hafuli123/AcGun-Gun-File/手册/0.91OLED/03-原理图/原理图.png

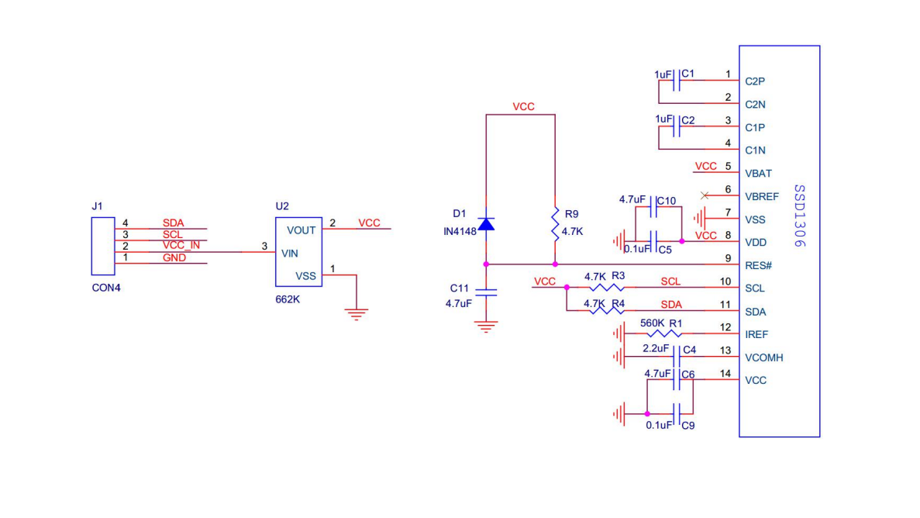
手册/0.91OLED/03-原理图/原理图.png
