hafuli123/AcGun-Gun-File/素材/PCtoLCD/取字设置.png

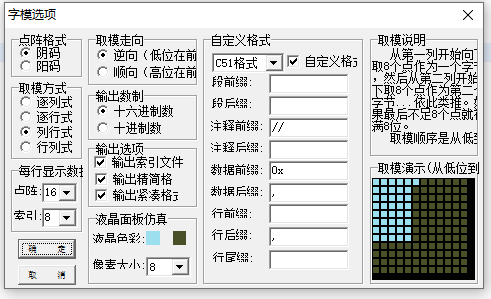
素材/PCtoLCD/取字设置.png
