hafuli123/AcGun-Gun-File/素材/PCtoLCD/字库工具/BAT(1).bmp

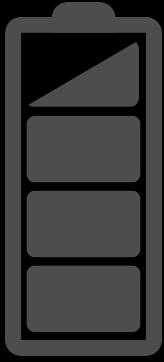
素材/PCtoLCD/字库工具/BAT(1).bmp
