hafuli123/AcGun-Gun-File/素材/PCtoLCD/字库工具/d4q25JmE3j.bmp

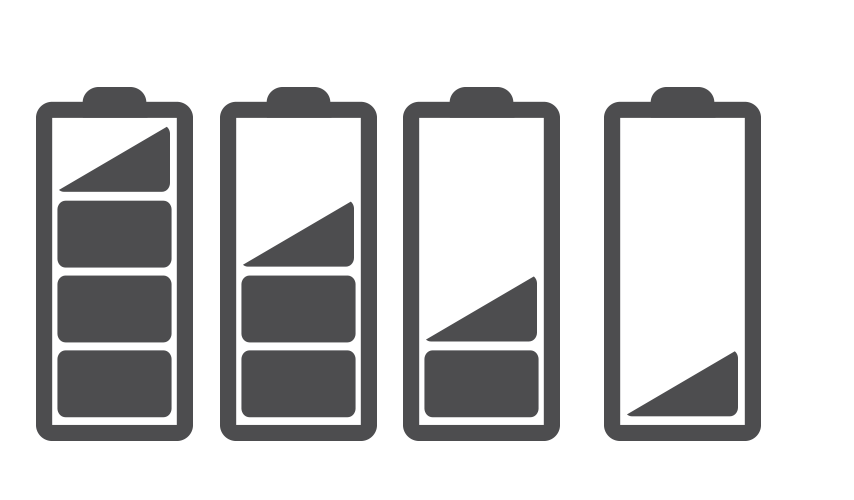
素材/PCtoLCD/字库工具/d4q25JmE3j.bmp
