hafuli123/AcGun-Gun-File/素材/PCtoLCD/字库工具/exLqBQ9P3N.bmp

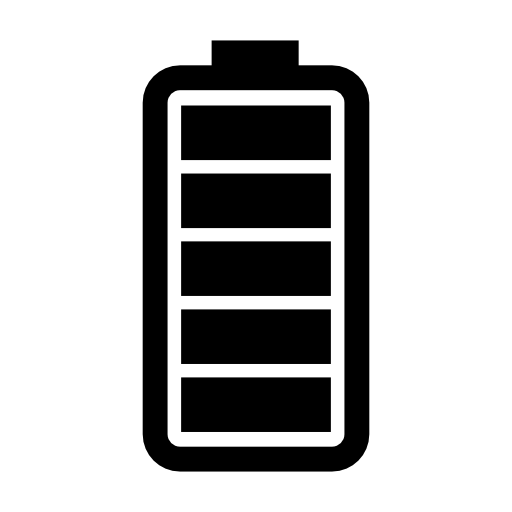
素材/PCtoLCD/字库工具/exLqBQ9P3N.bmp
