hafuli123/AcGun-Gun-File/硬件/H7相机板BOM.xlsx

No. | Quantity | Device | Designator | Footprint | Value
1 | 19 | CC0603KRX7R9BB104 | C1,C9,C12,C13,C16,C19,C20,C23,C26,C30,C32,C33,C34,C35,C36,C37,C38,C39，C40 | C0603 | 0.1uF
2 | 6 | CC0603KRX7R9BB105 | C2,C8,C14,C15,C29,C31 | C0603 | 1uF
3 | 2 | 0603X475M160NT | C3,C4 | C0603 | 4.7uF
4 | 3 | 0603CG220F500NT | C6,C27,C28 | C0603 | 22pF
5 | 8 | 0603X106K160NT | C5,C7，C10,C11,C17,C18,C21,C22 | C0603 | 10uF
6 | 2 | 0603CG150J500NT | C24,C25 | C0603 | 15pF
7 | 1 | HX25003-5A | CN1 | CONN-TH_5P-P2.50_HX25003-5A | 灯板连接口 2.54 5p直插 | 不贴
8 | 1 | HDGC2501WR-2P | CN2 | CONN-TH_2P-P2.50_HDGC2501WR-2P
9 | 1 | SS34_C8678 | D1 | DO-214AC_L4.3-W2.7-LS5.3-RD
10 | 2 | SS14A | D2,D3 | SMA_L4.3-W2.6-LS5.2-RD
11 | 4 | 3.3uh电感 | L1,L3,L4,L5 | 0420 | 3.3uH
12 | 1 | 2.2uh3a电感 | L2 | IND-SMD_L4.0-W4.0_0.47UH04209.5A | 2.2uH
13 | 1 | TLMG1100-GS08 | LED1 | 绿灯
14 | 1 | TLMG1100-GS08 | LED2 | 黄灯
15 | 1 | TLMS1000-GS08 | LED3 | 红灯
16 | 1 | AO3401_C181091 | Q1 | SOT-23-3_L2.9-W1.3-P1.90-LS2.4-BR
17 | 2 | AO3400 | Q2,Q3 | SOT-23_L2.9-W1.3-P1.90-LS2.4-BR
18 | 4 | 0603WAF1001T5E | R1,R19,R20,R21 | R0603 | 1kΩ
19 | 2 | 0603WAF2002T5E | R2,R17 | R0603 | 20kΩ
20 | 5 | 0603WAF1002T5E | R3,R4,R11,R14,R15 | R0603 | 10kΩ
21 | 2 | 0603WAF3002T5E | R5,R18 | R0603 | 30kΩ
22 | 1 | 0603WAF3001T5E | R6 | R0603 | 3kΩ
23 | 2 | 0603WAF4701T5E | R7,R8 | R0603 | 4.7kΩ
24 | 4 | 0603WAF1003T5E | R9,R12,R13,R25 | R0603 | 100kΩ
25 | 1 | RC0603FR-07453KL | R10 | R0603 | 453kΩ
26 | 1 | 0603WAF470JT5E | R16 | R0603 | 47Ω
27 | 1 | 0603WAF3003T5E | R22 | R0603 | 300kΩ
28 | 1 | 按键开关 | SW1 | 按钮开关
29 | 1 | 1TS001G-2700-1500-CT | SW3 | SW-SMD_4P-L5.1-W5.1-P3.70-LS6.5-TL-2
30 | 1 | 24M有源晶振 | U1 | 5032-4P |  | 不贴
31 | 1 | PW4056 | U2 | PW4056
32 | 1 | 相机排座 | U3 | OV2640
33 | 1 | HDGC1501WV-6P | U4 | CONN-TH_6P-P1.50_HDGC_HDGC1501WV-6P
34 | 1 | PW2051 | U5 | PW2051
35 | 2 | XC6206P282MR | U6,U10 | SOT-23-3_L2.9-W1.6-P1.90-LS2.9-BL
 | 1 | XC6206P132MR | U8 | SOT-23-3_L2.9-W1.6-P1.90-LS2.9-BL
36 | 1 | GC2400-TC010R | U7 | GC2400-TC010R
37 | 1 | W25Q64JVSSIQ_C83140 | U9 | SOP-8_L5.3-W5.3-P1.27-LS8.0-BL
38 | 1 | AS01-ML01IPX | U11 | WIRELM-SMD_8P-L19.0-W12.0-P1.27 |  | 不贴
39 | 1 | STM32H7B0VBT6 | U12 | LQFP-100_L14.0-W14.0-P0.50-LS16.0-BL
40 | 1 | XY-MBA32A | U13 | XY-MBA32A
41 | 1 | typec | USB1 | typec
42 | 1 | 32.768KHz晶振 | Y1 | 3215
43 | 1 | 25MHz无源晶振 | Y2 | XTAL3225
