hafuli123/AcGun-Gun-File/传感器两小板/pcb/压力板BOM.xlsx

No. | Quantity | Device | Designator | Footprint | Value
1 | 1 | 10cm 3P 线 | CN1 | 3POINT
2 | 1 | CR0603JA0103G | R1 | R0603 | 10kΩ
3 | 1 | FSS1500 | U1 | FSS1500NST
4 | 1 | INA333AIDGKR | U2 | MSOP-8_L3.0-W3.0-P0.65-LS5.0-BL
