hafuli123/AcGun-Gun-File/传感器两小板/pcb/磁感应板BOM.xlsx

No. | Quantity | Device | Designator | Footprint | Value
1 | 1 | 15cm 3P线 | CN1 | 3POINT
2 | 1 | TMR1302S | U1 | SOT-23-3_L2.9-W1.3-P1.90-LS2.4
