hafuli123/AcGun-Gun-File/硬件/激光主板BOM.xlsx

No. | Quantity | Device | Designator | Footprint | Value
1 | 1 | 0603F105M250NT | C1 | C0603 | 1uF
2 | 2 | 0603X475M160NT | C2,C4 | C0603 | 4.7uF
3 | 9 | 0603B104K101CT | C3,C6,C7,C8,C9,C10,C11,C14,C20 | C0603 | 0.1uF
4 | 3 | 0603X106M100CT | C5,C18,C22 | C0603 | 10uF
5 | 1 | 0603B225K160CT | C13 | C0603 | 2.2uF
6 | 2 | 0603CG150J500NT | C15,C16 | C0603 | 15pF
7 | 3 | 0603CG220F500NT | C17,C19,C21 | C0603 | 22pF
8 | 1 | HDGC2501WR-2P | CN1 | CONN-TH_2P-P2.50_HDGC2501WR-2P
9 | 1 | 喇叭 | CN2 | 喇叭接线点
10 | 3 | HDGC2001WR-2P | CN3,CN7,CN9 | CONN-TH_2P-P2.00_HDGC2001WR-2P
11 | 2 | HDGC1501WR-3P | CN4,CN5 | CONN-TH_3P-P1.50_HDGC1501WR-3P
12 | 1 | 1125-1104G0R138C002 | CN6 | HDR-TH_4P-P2.54-H-M-W9.4
13 | 1 | SS34_C8678 | D1 | DO-214AC_L4.3-W2.7-LS5.3-RD
14 | 2 | SS14A | D2,D3 | SMA_L4.3-W2.6-LS5.2-RD
15 | 1 | 2.2uh3a电感 | L1 | IND-SMD_L4.0-W4.0_0.47UH04209.5A | 2.2uH
16 | 1 | AO3401_C181091 | Q1 | SOT-23-3_L2.9-W1.3-P1.90-LS2.4-BR
17 | 2 | AO3400 | Q2,Q4 | SOT-23_L2.9-W1.3-P1.90-LS2.4-BR
18 | 4 | S8050 | Q5,Q6,Q7 | SOT-23_L2.9-W1.3-P1.90-LS2.4-BR
19 | 1 | FMMT493 | Q3 | SOT-23-3
20 | 2 | RC0603DR-0720KL | R1,R3 | R0603 | 20kΩ
21 | 5 | TR0603B1K00P0525Z | R2,R10,R15,R19,R24 | R0603 | 1kΩ
22 | 10 | SY0603JN10KP | R4,R7,R11,R12,R13,R17,R18,R20,R22,R25 | R0603 | 10kΩ
23 | 1 | 0603WAJ0302T5E | R5 | R0603 | 3kΩ
24 | 2 | AC0603FR-0730KL | R6,R8 | R0603 | 30kΩ
25 | 4 | MCT06030C1003FP500 | R9,R16,R26,R27 | R0603 | 100kΩ
26 | 1 | RC0603FR-07300KL | R14 | R0603 | 300kΩ
27 | 1 | RMC 0603 4K7 F N | R21 | R0603 | 4.7kΩ
28 | 1 | 0603WAF4533T5E | R23 | R0603 | 453kΩ
29 | 2 | 按键开关 | SW1,SW2 | 按钮开关
30 | 1 | 1TS001G-2700-1500-CT | SW3 | SW-SMD_4P-L5.1-W5.1-P3.70-LS6.5-TL-2
31 | 1 | PW4056 | U1 | PW4056
32 | 1 | W25Q128JVSIQ | U2 | SOIC-8_L5.3-W5.3-P1.27-LS8.0-BL
33 | 1 | MY2480 | U3 | MY2480
34 | 1 | STM32F401RCT6 | U4 | LQFP-64_L10.0-W10.0-P0.50-LS12.0-BL
35 | 1 | PW2051 | U5 | PW2051
36 | 1 | GC2400-TC010R | U6 | GC2400-TC010R
37 | 1 | 长型OLED屏幕 | U7 | OLED模块封装
38 | 1 | typec | USB1 | typec
39 | 1 | 32.768KHz晶振 | Y1 | 3215
40 | 1 | 8MHz晶振 | Y2 | 5032
