hafuli123/AcGun-Gun-File/软件/初始化无线模块/gc24init/MDK-ARM/testuart2/testuart2.htm

# Static Call Graph for image testuart2\testuart2.axf

#<CALLGRAPH># ARM Linker, 5060422: Last Updated: Fri Jul 21 09:25:18 2023

### Maximum Stack Usage = 256 bytes + Unknown(Functions without stacksize, Cycles, Untraceable Function Pointers)

### Call chain for Maximum Stack Depth:

__rt_entry_main ⇒ main ⇒ SystemClock_Config ⇒ HAL_RCC_ClockConfig ⇒ HAL_RCC_GetSysClockFreq ⇒ __aeabi_uldivmod

### Functions with no stack information

- __user_initial_stackheap

### Mutually Recursive functions

- ADC_IRQHandler ⇒ ADC_IRQHandler
- BusFault_Handler ⇒ BusFault_Handler
- HardFault_Handler ⇒ HardFault_Handler
- MemManage_Handler ⇒ MemManage_Handler
- NMI_Handler ⇒ NMI_Handler
- UsageFault_Handler ⇒ UsageFault_Handler

### Function Pointers

- ADC_IRQHandler from startup_stm32f401xc.o(.text) referenced from startup_stm32f401xc.o(RESET)
- BusFault_Handler from stm32f4xx_it.o(i.BusFault_Handler) referenced from startup_stm32f401xc.o(RESET)
- DMA1_Stream0_IRQHandler from startup_stm32f401xc.o(.text) referenced from startup_stm32f401xc.o(RESET)
- DMA1_Stream1_IRQHandler from startup_stm32f401xc.o(.text) referenced from startup_stm32f401xc.o(RESET)
- DMA1_Stream2_IRQHandler from startup_stm32f401xc.o(.text) referenced from startup_stm32f401xc.o(RESET)
- DMA1_Stream3_IRQHandler from startup_stm32f401xc.o(.text) referenced from startup_stm32f401xc.o(RESET)
- DMA1_Stream4_IRQHandler from startup_stm32f401xc.o(.text) referenced from startup_stm32f401xc.o(RESET)
- DMA1_Stream5_IRQHandler from startup_stm32f401xc.o(.text) referenced from startup_stm32f401xc.o(RESET)
- DMA1_Stream6_IRQHandler from startup_stm32f401xc.o(.text) referenced from startup_stm32f401xc.o(RESET)
- DMA1_Stream7_IRQHandler from startup_stm32f401xc.o(.text) referenced from startup_stm32f401xc.o(RESET)
- DMA2_Stream0_IRQHandler from startup_stm32f401xc.o(.text) referenced from startup_stm32f401xc.o(RESET)
- DMA2_Stream1_IRQHandler from startup_stm32f401xc.o(.text) referenced from startup_stm32f401xc.o(RESET)
- DMA2_Stream2_IRQHandler from startup_stm32f401xc.o(.text) referenced from startup_stm32f401xc.o(RESET)
- DMA2_Stream3_IRQHandler from startup_stm32f401xc.o(.text) referenced from startup_stm32f401xc.o(RESET)
- DMA2_Stream4_IRQHandler from startup_stm32f401xc.o(.text) referenced from startup_stm32f401xc.o(RESET)
- DMA2_Stream5_IRQHandler from startup_stm32f401xc.o(.text) referenced from startup_stm32f401xc.o(RESET)
- DMA2_Stream6_IRQHandler from startup_stm32f401xc.o(.text) referenced from startup_stm32f401xc.o(RESET)
- DMA2_Stream7_IRQHandler from startup_stm32f401xc.o(.text) referenced from startup_stm32f401xc.o(RESET)
- DebugMon_Handler from stm32f4xx_it.o(i.DebugMon_Handler) referenced from startup_stm32f401xc.o(RESET)
- EXTI0_IRQHandler from startup_stm32f401xc.o(.text) referenced from startup_stm32f401xc.o(RESET)
- EXTI15_10_IRQHandler from startup_stm32f401xc.o(.text) referenced from startup_stm32f401xc.o(RESET)
- EXTI1_IRQHandler from startup_stm32f401xc.o(.text) referenced from startup_stm32f401xc.o(RESET)
- EXTI2_IRQHandler from startup_stm32f401xc.o(.text) referenced from startup_stm32f401xc.o(RESET)
- EXTI3_IRQHandler from startup_stm32f401xc.o(.text) referenced from startup_stm32f401xc.o(RESET)
- EXTI4_IRQHandler from startup_stm32f401xc.o(.text) referenced from startup_stm32f401xc.o(RESET)
- EXTI9_5_IRQHandler from startup_stm32f401xc.o(.text) referenced from startup_stm32f401xc.o(RESET)
- FLASH_IRQHandler from startup_stm32f401xc.o(.text) referenced from startup_stm32f401xc.o(RESET)
- FPU_IRQHandler from startup_stm32f401xc.o(.text) referenced from startup_stm32f401xc.o(RESET)
- HardFault_Handler from stm32f4xx_it.o(i.HardFault_Handler) referenced from startup_stm32f401xc.o(RESET)
- I2C1_ER_IRQHandler from startup_stm32f401xc.o(.text) referenced from startup_stm32f401xc.o(RESET)
- I2C1_EV_IRQHandler from startup_stm32f401xc.o(.text) referenced from startup_stm32f401xc.o(RESET)
- I2C2_ER_IRQHandler from startup_stm32f401xc.o(.text) referenced from startup_stm32f401xc.o(RESET)
- I2C2_EV_IRQHandler from startup_stm32f401xc.o(.text) referenced from startup_stm32f401xc.o(RESET)
- I2C3_ER_IRQHandler from startup_stm32f401xc.o(.text) referenced from startup_stm32f401xc.o(RESET)
- I2C3_EV_IRQHandler from startup_stm32f401xc.o(.text) referenced from startup_stm32f401xc.o(RESET)
- MemManage_Handler from stm32f4xx_it.o(i.MemManage_Handler) referenced from startup_stm32f401xc.o(RESET)
- NMI_Handler from stm32f4xx_it.o(i.NMI_Handler) referenced from startup_stm32f401xc.o(RESET)
- OTG_FS_IRQHandler from startup_stm32f401xc.o(.text) referenced from startup_stm32f401xc.o(RESET)
- OTG_FS_WKUP_IRQHandler from startup_stm32f401xc.o(.text) referenced from startup_stm32f401xc.o(RESET)
- PVD_IRQHandler from startup_stm32f401xc.o(.text) referenced from startup_stm32f401xc.o(RESET)
- PendSV_Handler from stm32f4xx_it.o(i.PendSV_Handler) referenced from startup_stm32f401xc.o(RESET)
- RCC_IRQHandler from startup_stm32f401xc.o(.text) referenced from startup_stm32f401xc.o(RESET)
- RTC_Alarm_IRQHandler from startup_stm32f401xc.o(.text) referenced from startup_stm32f401xc.o(RESET)
- RTC_WKUP_IRQHandler from startup_stm32f401xc.o(.text) referenced from startup_stm32f401xc.o(RESET)
- Reset_Handler from startup_stm32f401xc.o(.text) referenced from startup_stm32f401xc.o(RESET)
- SDIO_IRQHandler from startup_stm32f401xc.o(.text) referenced from startup_stm32f401xc.o(RESET)
- SPI1_IRQHandler from startup_stm32f401xc.o(.text) referenced from startup_stm32f401xc.o(RESET)
- SPI2_IRQHandler from startup_stm32f401xc.o(.text) referenced from startup_stm32f401xc.o(RESET)
- SPI3_IRQHandler from startup_stm32f401xc.o(.text) referenced from startup_stm32f401xc.o(RESET)
- SPI4_IRQHandler from startup_stm32f401xc.o(.text) referenced from startup_stm32f401xc.o(RESET)
- SVC_Handler from stm32f4xx_it.o(i.SVC_Handler) referenced from startup_stm32f401xc.o(RESET)
- SysTick_Handler from stm32f4xx_it.o(i.SysTick_Handler) referenced from startup_stm32f401xc.o(RESET)
- SystemInit from system_stm32f4xx.o(i.SystemInit) referenced from startup_stm32f401xc.o(.text)
- TAMP_STAMP_IRQHandler from startup_stm32f401xc.o(.text) referenced from startup_stm32f401xc.o(RESET)
- TIM1_BRK_TIM9_IRQHandler from startup_stm32f401xc.o(.text) referenced from startup_stm32f401xc.o(RESET)
- TIM1_CC_IRQHandler from startup_stm32f401xc.o(.text) referenced from startup_stm32f401xc.o(RESET)
- TIM1_TRG_COM_TIM11_IRQHandler from startup_stm32f401xc.o(.text) referenced from startup_stm32f401xc.o(RESET)
- TIM1_UP_TIM10_IRQHandler from startup_stm32f401xc.o(.text) referenced from startup_stm32f401xc.o(RESET)
- TIM2_IRQHandler from startup_stm32f401xc.o(.text) referenced from startup_stm32f401xc.o(RESET)
- TIM3_IRQHandler from startup_stm32f401xc.o(.text) referenced from startup_stm32f401xc.o(RESET)
- TIM4_IRQHandler from startup_stm32f401xc.o(.text) referenced from startup_stm32f401xc.o(RESET)
- TIM5_IRQHandler from startup_stm32f401xc.o(.text) referenced from startup_stm32f401xc.o(RESET)
- USART1_IRQHandler from main.o(i.USART1_IRQHandler) referenced from startup_stm32f401xc.o(RESET)
- USART2_IRQHandler from startup_stm32f401xc.o(.text) referenced from startup_stm32f401xc.o(RESET)
- USART6_IRQHandler from startup_stm32f401xc.o(.text) referenced from startup_stm32f401xc.o(RESET)
- UsageFault_Handler from stm32f4xx_it.o(i.UsageFault_Handler) referenced from startup_stm32f401xc.o(RESET)
- WWDG_IRQHandler from startup_stm32f401xc.o(.text) referenced from startup_stm32f401xc.o(RESET)
- __main from __main.o(!!!main) referenced from startup_stm32f401xc.o(.text)

### Global Symbols

__main (Thumb, 8 bytes, Stack size 0 bytes, __main.o(!!!main))

[Calls]

- >> __scatterload
- >> __rt_entry

__scatterload (Thumb, 0 bytes, Stack size unknown bytes, __scatter.o(!!!scatter))

[Called By]

- >> __main

__scatterload_rt2 (Thumb, 44 bytes, Stack size unknown bytes, __scatter.o(!!!scatter), UNUSED)

[Calls]

- >> __rt_entry

__scatterload_rt2_thumb_only (Thumb, 0 bytes, Stack size unknown bytes, __scatter.o(!!!scatter), UNUSED)

__scatterload_null (Thumb, 0 bytes, Stack size unknown bytes, __scatter.o(!!!scatter), UNUSED)

__scatterload_copy (Thumb, 26 bytes, Stack size unknown bytes, __scatter_copy.o(!!handler_copy), UNUSED)

[Calls]

- >> __scatterload_copy

[Called By]

- >> __scatterload_copy

__scatterload_zeroinit (Thumb, 28 bytes, Stack size unknown bytes, __scatter_zi.o(!!handler_zi), UNUSED)

__rt_lib_init (Thumb, 0 bytes, Stack size unknown bytes, libinit.o(.ARM.Collect$$libinit$$00000000))

[Called By]

- >> __rt_entry_li

__rt_lib_init_fp_1 (Thumb, 0 bytes, Stack size unknown bytes, libinit2.o(.ARM.Collect$$libinit$$00000001))

[Calls]

- >> _fp_init

__rt_lib_init_alloca_1 (Thumb, 0 bytes, Stack size unknown bytes, libinit2.o(.ARM.Collect$$libinit$$0000002E))

__rt_lib_init_argv_1 (Thumb, 0 bytes, Stack size unknown bytes, libinit2.o(.ARM.Collect$$libinit$$0000002C))

__rt_lib_init_atexit_1 (Thumb, 0 bytes, Stack size unknown bytes, libinit2.o(.ARM.Collect$$libinit$$0000001B))

__rt_lib_init_clock_1 (Thumb, 0 bytes, Stack size unknown bytes, libinit2.o(.ARM.Collect$$libinit$$00000021))

__rt_lib_init_cpp_1 (Thumb, 0 bytes, Stack size unknown bytes, libinit2.o(.ARM.Collect$$libinit$$00000032))

__rt_lib_init_exceptions_1 (Thumb, 0 bytes, Stack size unknown bytes, libinit2.o(.ARM.Collect$$libinit$$00000030))

__rt_lib_init_fp_trap_1 (Thumb, 0 bytes, Stack size unknown bytes, libinit2.o(.ARM.Collect$$libinit$$0000001F))

__rt_lib_init_getenv_1 (Thumb, 0 bytes, Stack size unknown bytes, libinit2.o(.ARM.Collect$$libinit$$00000023))

__rt_lib_init_heap_1 (Thumb, 0 bytes, Stack size unknown bytes, libinit2.o(.ARM.Collect$$libinit$$0000000A))

__rt_lib_init_lc_collate_1 (Thumb, 0 bytes, Stack size unknown bytes, libinit2.o(.ARM.Collect$$libinit$$00000011))

__rt_lib_init_lc_ctype_1 (Thumb, 0 bytes, Stack size unknown bytes, libinit2.o(.ARM.Collect$$libinit$$00000013))

__rt_lib_init_lc_monetary_1 (Thumb, 0 bytes, Stack size unknown bytes, libinit2.o(.ARM.Collect$$libinit$$00000015))

__rt_lib_init_lc_numeric_1 (Thumb, 0 bytes, Stack size unknown bytes, libinit2.o(.ARM.Collect$$libinit$$00000017))

__rt_lib_init_lc_time_1 (Thumb, 0 bytes, Stack size unknown bytes, libinit2.o(.ARM.Collect$$libinit$$00000019))

__rt_lib_init_preinit_1 (Thumb, 0 bytes, Stack size unknown bytes, libinit2.o(.ARM.Collect$$libinit$$00000004))

__rt_lib_init_rand_1 (Thumb, 0 bytes, Stack size unknown bytes, libinit2.o(.ARM.Collect$$libinit$$0000000E))

__rt_lib_init_return (Thumb, 0 bytes, Stack size unknown bytes, libinit2.o(.ARM.Collect$$libinit$$00000033))

__rt_lib_init_signal_1 (Thumb, 0 bytes, Stack size unknown bytes, libinit2.o(.ARM.Collect$$libinit$$0000001D))

__rt_lib_init_stdio_1 (Thumb, 0 bytes, Stack size unknown bytes, libinit2.o(.ARM.Collect$$libinit$$00000025))

__rt_lib_init_user_alloc_1 (Thumb, 0 bytes, Stack size unknown bytes, libinit2.o(.ARM.Collect$$libinit$$0000000C))

__rt_lib_shutdown (Thumb, 0 bytes, Stack size unknown bytes, libshutdown.o(.ARM.Collect$$libshutdown$$00000000))

[Called By]

- >> __rt_exit_ls

__rt_lib_shutdown_cpp_1 (Thumb, 0 bytes, Stack size unknown bytes, libshutdown2.o(.ARM.Collect$$libshutdown$$00000002))

__rt_lib_shutdown_fp_trap_1 (Thumb, 0 bytes, Stack size unknown bytes, libshutdown2.o(.ARM.Collect$$libshutdown$$00000007))

__rt_lib_shutdown_heap_1 (Thumb, 0 bytes, Stack size unknown bytes, libshutdown2.o(.ARM.Collect$$libshutdown$$0000000F))

__rt_lib_shutdown_return (Thumb, 0 bytes, Stack size unknown bytes, libshutdown2.o(.ARM.Collect$$libshutdown$$00000010))

__rt_lib_shutdown_signal_1 (Thumb, 0 bytes, Stack size unknown bytes, libshutdown2.o(.ARM.Collect$$libshutdown$$0000000A))

__rt_lib_shutdown_stdio_1 (Thumb, 0 bytes, Stack size unknown bytes, libshutdown2.o(.ARM.Collect$$libshutdown$$00000004))

__rt_lib_shutdown_user_alloc_1 (Thumb, 0 bytes, Stack size unknown bytes, libshutdown2.o(.ARM.Collect$$libshutdown$$0000000C))

__rt_entry (Thumb, 0 bytes, Stack size unknown bytes, __rtentry.o(.ARM.Collect$$rtentry$$00000000))

[Called By]

- >> __scatterload_rt2
- >> __main

__rt_entry_presh_1 (Thumb, 0 bytes, Stack size unknown bytes, __rtentry2.o(.ARM.Collect$$rtentry$$00000002))

__rt_entry_sh (Thumb, 0 bytes, Stack size unknown bytes, __rtentry4.o(.ARM.Collect$$rtentry$$00000004))

[Stack]

- Max Depth = 8 + Unknown Stack Size
- Call Chain = __rt_entry_sh ⇒ __user_setup_stackheap

[Calls]

- >> __user_setup_stackheap

__rt_entry_li (Thumb, 0 bytes, Stack size unknown bytes, __rtentry2.o(.ARM.Collect$$rtentry$$0000000A))

[Calls]

- >> __rt_lib_init

__rt_entry_postsh_1 (Thumb, 0 bytes, Stack size unknown bytes, __rtentry2.o(.ARM.Collect$$rtentry$$00000009))

__rt_entry_main (Thumb, 0 bytes, Stack size unknown bytes, __rtentry2.o(.ARM.Collect$$rtentry$$0000000D))

[Stack]

- Max Depth = 256 + Unknown Stack Size
- Call Chain = __rt_entry_main ⇒ main ⇒ SystemClock_Config ⇒ HAL_RCC_ClockConfig ⇒ HAL_RCC_GetSysClockFreq ⇒ __aeabi_uldivmod

[Calls]

- >> main
- >> exit

__rt_entry_postli_1 (Thumb, 0 bytes, Stack size unknown bytes, __rtentry2.o(.ARM.Collect$$rtentry$$0000000C))

__rt_exit (Thumb, 0 bytes, Stack size unknown bytes, rtexit.o(.ARM.Collect$$rtexit$$00000000))

[Called By]

- >> exit

__rt_exit_ls (Thumb, 0 bytes, Stack size unknown bytes, rtexit2.o(.ARM.Collect$$rtexit$$00000003))

[Calls]

- >> __rt_lib_shutdown

__rt_exit_prels_1 (Thumb, 0 bytes, Stack size unknown bytes, rtexit2.o(.ARM.Collect$$rtexit$$00000002))

__rt_exit_exit (Thumb, 0 bytes, Stack size unknown bytes, rtexit2.o(.ARM.Collect$$rtexit$$00000004))

[Calls]

- >> _sys_exit

Reset_Handler (Thumb, 8 bytes, Stack size 0 bytes, startup_stm32f401xc.o(.text))
[Address Reference Count : 1]

- startup_stm32f401xc.o(RESET)

ADC_IRQHandler (Thumb, 0 bytes, Stack size 0 bytes, startup_stm32f401xc.o(.text))

[Calls]

- >> ADC_IRQHandler

[Called By]

- >> ADC_IRQHandler

[Address Reference Count : 1]

- startup_stm32f401xc.o(RESET)

DMA1_Stream0_IRQHandler (Thumb, 0 bytes, Stack size 0 bytes, startup_stm32f401xc.o(.text))
[Address Reference Count : 1]

- startup_stm32f401xc.o(RESET)

DMA1_Stream1_IRQHandler (Thumb, 0 bytes, Stack size 0 bytes, startup_stm32f401xc.o(.text))
[Address Reference Count : 1]

- startup_stm32f401xc.o(RESET)

DMA1_Stream2_IRQHandler (Thumb, 0 bytes, Stack size 0 bytes, startup_stm32f401xc.o(.text))
[Address Reference Count : 1]

- startup_stm32f401xc.o(RESET)

DMA1_Stream3_IRQHandler (Thumb, 0 bytes, Stack size 0 bytes, startup_stm32f401xc.o(.text))
[Address Reference Count : 1]

- startup_stm32f401xc.o(RESET)

DMA1_Stream4_IRQHandler (Thumb, 0 bytes, Stack size 0 bytes, startup_stm32f401xc.o(.text))
[Address Reference Count : 1]

- startup_stm32f401xc.o(RESET)

DMA1_Stream5_IRQHandler (Thumb, 0 bytes, Stack size 0 bytes, startup_stm32f401xc.o(.text))
[Address Reference Count : 1]

- startup_stm32f401xc.o(RESET)

DMA1_Stream6_IRQHandler (Thumb, 0 bytes, Stack size 0 bytes, startup_stm32f401xc.o(.text))
[Address Reference Count : 1]

- startup_stm32f401xc.o(RESET)

DMA1_Stream7_IRQHandler (Thumb, 0 bytes, Stack size 0 bytes, startup_stm32f401xc.o(.text))
[Address Reference Count : 1]

- startup_stm32f401xc.o(RESET)

DMA2_Stream0_IRQHandler (Thumb, 0 bytes, Stack size 0 bytes, startup_stm32f401xc.o(.text))
[Address Reference Count : 1]

- startup_stm32f401xc.o(RESET)

DMA2_Stream1_IRQHandler (Thumb, 0 bytes, Stack size 0 bytes, startup_stm32f401xc.o(.text))
[Address Reference Count : 1]

- startup_stm32f401xc.o(RESET)

DMA2_Stream2_IRQHandler (Thumb, 0 bytes, Stack size 0 bytes, startup_stm32f401xc.o(.text))
[Address Reference Count : 1]

- startup_stm32f401xc.o(RESET)

DMA2_Stream3_IRQHandler (Thumb, 0 bytes, Stack size 0 bytes, startup_stm32f401xc.o(.text))
[Address Reference Count : 1]

- startup_stm32f401xc.o(RESET)

DMA2_Stream4_IRQHandler (Thumb, 0 bytes, Stack size 0 bytes, startup_stm32f401xc.o(.text))
[Address Reference Count : 1]

- startup_stm32f401xc.o(RESET)

DMA2_Stream5_IRQHandler (Thumb, 0 bytes, Stack size 0 bytes, startup_stm32f401xc.o(.text))
[Address Reference Count : 1]

- startup_stm32f401xc.o(RESET)

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
[Address Reference Count : 1]

- startup_stm32f401xc.o(RESET)

TIM1_BRK_TIM9_IRQHandler (Thumb, 0 bytes, Stack size 0 bytes, startup_stm32f401xc.o(.text))
[Address Reference Count : 1]

- startup_stm32f401xc.o(RESET)

TIM1_CC_IRQHandler (Thumb, 0 bytes, Stack size 0 bytes, startup_stm32f401xc.o(.text))
[Address Reference Count : 1]

- startup_stm32f401xc.o(RESET)

TIM1_TRG_COM_TIM11_IRQHandler (Thumb, 0 bytes, Stack size 0 bytes, startup_stm32f401xc.o(.text))
[Address Reference Count : 1]

- startup_stm32f401xc.o(RESET)

TIM1_UP_TIM10_IRQHandler (Thumb, 0 bytes, Stack size 0 bytes, startup_stm32f401xc.o(.text))
[Address Reference Count : 1]

- startup_stm32f401xc.o(RESET)

TIM2_IRQHandler (Thumb, 0 bytes, Stack size 0 bytes, startup_stm32f401xc.o(.text))
[Address Reference Count : 1]

- startup_stm32f401xc.o(RESET)

TIM3_IRQHandler (Thumb, 0 bytes, Stack size 0 bytes, startup_stm32f401xc.o(.text))
[Address Reference Count : 1]

- startup_stm32f401xc.o(RESET)

TIM4_IRQHandler (Thumb, 0 bytes, Stack size 0 bytes, startup_stm32f401xc.o(.text))
[Address Reference Count : 1]

- startup_stm32f401xc.o(RESET)

TIM5_IRQHandler (Thumb, 0 bytes, Stack size 0 bytes, startup_stm32f401xc.o(.text))
[Address Reference Count : 1]

- startup_stm32f401xc.o(RESET)

USART2_IRQHandler (Thumb, 0 bytes, Stack size 0 bytes, startup_stm32f401xc.o(.text))
[Address Reference Count : 1]

- startup_stm32f401xc.o(RESET)

USART6_IRQHandler (Thumb, 0 bytes, Stack size 0 bytes, startup_stm32f401xc.o(.text))
[Address Reference Count : 1]

- startup_stm32f401xc.o(RESET)

WWDG_IRQHandler (Thumb, 0 bytes, Stack size 0 bytes, startup_stm32f401xc.o(.text))
[Address Reference Count : 1]

- startup_stm32f401xc.o(RESET)

__user_initial_stackheap (Thumb, 0 bytes, Stack size unknown bytes, startup_stm32f401xc.o(.text))

[Called By]

- >> __user_setup_stackheap

__aeabi_uldivmod (Thumb, 0 bytes, Stack size 48 bytes, lludivv7m.o(.text))

[Stack]

- Max Depth = 48
- Call Chain = __aeabi_uldivmod

[Called By]

- >> UART_SetConfig
- >> HAL_RCC_GetSysClockFreq

_ll_udiv (Thumb, 238 bytes, Stack size 48 bytes, lludivv7m.o(.text), UNUSED)

strlen (Thumb, 62 bytes, Stack size 8 bytes, strlen.o(.text))

[Stack]

- Max Depth = 8
- Call Chain = strlen

[Called By]

- >> main

__aeabi_memcpy4 (Thumb, 0 bytes, Stack size 8 bytes, rt_memcpy_w.o(.text))

[Stack]

- Max Depth = 8
- Call Chain = __aeabi_memcpy4

[Called By]

- >> main

__aeabi_memcpy8 (Thumb, 0 bytes, Stack size 8 bytes, rt_memcpy_w.o(.text), UNUSED)

__rt_memcpy_w (Thumb, 100 bytes, Stack size 8 bytes, rt_memcpy_w.o(.text), UNUSED)

_memcpy_lastbytes_aligned (Thumb, 0 bytes, Stack size unknown bytes, rt_memcpy_w.o(.text), UNUSED)

__aeabi_memclr4 (Thumb, 0 bytes, Stack size 4 bytes, rt_memclr_w.o(.text))

[Stack]

- Max Depth = 4
- Call Chain = __aeabi_memclr4

[Called By]

- >> MX_GPIO_Init
- >> SystemClock_Config

__aeabi_memclr8 (Thumb, 0 bytes, Stack size 4 bytes, rt_memclr_w.o(.text), UNUSED)

__rt_memclr_w (Thumb, 78 bytes, Stack size 4 bytes, rt_memclr_w.o(.text), UNUSED)

_memset_w (Thumb, 0 bytes, Stack size unknown bytes, rt_memclr_w.o(.text), UNUSED)

__use_two_region_memory (Thumb, 2 bytes, Stack size 0 bytes, heapauxi.o(.text), UNUSED)

__rt_heap_escrow$2region (Thumb, 2 bytes, Stack size 0 bytes, heapauxi.o(.text), UNUSED)

__rt_heap_expand$2region (Thumb, 2 bytes, Stack size 0 bytes, heapauxi.o(.text), UNUSED)

__user_setup_stackheap (Thumb, 74 bytes, Stack size 8 bytes, sys_stackheap_outer.o(.text))

[Stack]

- Max Depth = 8 + Unknown Stack Size
- Call Chain = __user_setup_stackheap

[Calls]

- >> __user_initial_stackheap
- >> __user_perproc_libspace

[Called By]

- >> __rt_entry_sh

exit (Thumb, 18 bytes, Stack size 8 bytes, exit.o(.text))

[Stack]

- Max Depth = 8 + Unknown Stack Size
- Call Chain = exit

[Calls]

- >> __rt_exit

[Called By]

- >> __rt_entry_main

__user_libspace (Thumb, 8 bytes, Stack size 0 bytes, libspace.o(.text), UNUSED)

__user_perproc_libspace (Thumb, 0 bytes, Stack size 0 bytes, libspace.o(.text))

[Called By]

- >> __user_setup_stackheap

__user_perthread_libspace (Thumb, 0 bytes, Stack size 0 bytes, libspace.o(.text), UNUSED)

_sys_exit (Thumb, 8 bytes, Stack size 0 bytes, sys_exit.o(.text))

[Called By]

- >> __rt_exit_exit

__I$use$semihosting (Thumb, 0 bytes, Stack size 0 bytes, use_no_semi.o(.text), UNUSED)

__use_no_semihosting_swi (Thumb, 2 bytes, Stack size 0 bytes, use_no_semi.o(.text), UNUSED)

BusFault_Handler (Thumb, 2 bytes, Stack size 0 bytes, stm32f4xx_it.o(i.BusFault_Handler))

[Calls]

- >> BusFault_Handler

[Called By]

- >> BusFault_Handler

[Address Reference Count : 1]

- startup_stm32f401xc.o(RESET)

__semihosting_library_function (Thumb, 0 bytes, Stack size 0 bytes, indicate_semi.o(.text), UNUSED)

DebugMon_Handler (Thumb, 2 bytes, Stack size 0 bytes, stm32f4xx_it.o(i.DebugMon_Handler))
[Address Reference Count : 1]

- startup_stm32f401xc.o(RESET)

HAL_Delay (Thumb, 32 bytes, Stack size 16 bytes, stm32f4xx_hal.o(i.HAL_Delay))

[Stack]

- Max Depth = 16
- Call Chain = HAL_Delay

[Calls]

- >> HAL_GetTick

[Called By]

- >> main

HAL_GPIO_Init (Thumb, 446 bytes, Stack size 40 bytes, stm32f4xx_hal_gpio.o(i.HAL_GPIO_Init))

[Stack]

- Max Depth = 40
- Call Chain = HAL_GPIO_Init

[Called By]

- >> HAL_UART_MspInit
- >> MX_GPIO_Init

HAL_GPIO_WritePin (Thumb, 10 bytes, Stack size 0 bytes, stm32f4xx_hal_gpio.o(i.HAL_GPIO_WritePin))

[Called By]

- >> MX_GPIO_Init

HAL_GetTick (Thumb, 6 bytes, Stack size 0 bytes, stm32f4xx_hal.o(i.HAL_GetTick))

[Called By]

- >> UART_WaitOnFlagUntilTimeout
- >> HAL_UART_Transmit
- >> HAL_RCC_OscConfig
- >> HAL_RCC_ClockConfig
- >> HAL_Delay

HAL_IncTick (Thumb, 12 bytes, Stack size 0 bytes, stm32f4xx_hal.o(i.HAL_IncTick))

[Called By]

- >> SysTick_Handler

HAL_Init (Thumb, 48 bytes, Stack size 8 bytes, stm32f4xx_hal.o(i.HAL_Init))

[Stack]

- Max Depth = 40
- Call Chain = HAL_Init ⇒ HAL_InitTick ⇒ HAL_NVIC_SetPriority

[Calls]

- >> HAL_MspInit
- >> HAL_InitTick
- >> HAL_NVIC_SetPriorityGrouping

[Called By]

- >> main

HAL_InitTick (Thumb, 54 bytes, Stack size 16 bytes, stm32f4xx_hal.o(i.HAL_InitTick))

[Stack]

- Max Depth = 32
- Call Chain = HAL_InitTick ⇒ HAL_NVIC_SetPriority

[Calls]

- >> HAL_NVIC_SetPriority
- >> HAL_SYSTICK_Config

[Called By]

- >> HAL_RCC_ClockConfig
- >> HAL_Init

HAL_MspInit (Thumb, 42 bytes, Stack size 8 bytes, stm32f4xx_hal_msp.o(i.HAL_MspInit))

[Stack]

- Max Depth = 8
- Call Chain = HAL_MspInit

[Called By]

- >> HAL_Init

HAL_NVIC_EnableIRQ (Thumb, 26 bytes, Stack size 0 bytes, stm32f4xx_hal_cortex.o(i.HAL_NVIC_EnableIRQ))

[Called By]

- >> MX_USARTx_Init

HAL_NVIC_SetPriority (Thumb, 60 bytes, Stack size 16 bytes, stm32f4xx_hal_cortex.o(i.HAL_NVIC_SetPriority))

[Stack]

- Max Depth = 16
- Call Chain = HAL_NVIC_SetPriority

[Calls]

- >> __NVIC_SetPriority

[Called By]

- >> MX_USARTx_Init
- >> HAL_InitTick

HAL_NVIC_SetPriorityGrouping (Thumb, 26 bytes, Stack size 0 bytes, stm32f4xx_hal_cortex.o(i.HAL_NVIC_SetPriorityGrouping))

[Called By]

- >> HAL_Init

HAL_RCC_ClockConfig (Thumb, 288 bytes, Stack size 32 bytes, stm32f4xx_hal_rcc.o(i.HAL_RCC_ClockConfig))

[Stack]

- Max Depth = 88
- Call Chain = HAL_RCC_ClockConfig ⇒ HAL_RCC_GetSysClockFreq ⇒ __aeabi_uldivmod

[Calls]

- >> HAL_RCC_GetSysClockFreq
- >> HAL_InitTick
- >> HAL_GetTick

[Called By]

- >> SystemClock_Config

HAL_RCC_GetPCLK1Freq (Thumb, 20 bytes, Stack size 0 bytes, stm32f4xx_hal_rcc.o(i.HAL_RCC_GetPCLK1Freq))

[Called By]

- >> UART_SetConfig

HAL_RCC_GetPCLK2Freq (Thumb, 20 bytes, Stack size 0 bytes, stm32f4xx_hal_rcc.o(i.HAL_RCC_GetPCLK2Freq))

[Called By]

- >> UART_SetConfig

HAL_RCC_GetSysClockFreq (Thumb, 88 bytes, Stack size 8 bytes, stm32f4xx_hal_rcc.o(i.HAL_RCC_GetSysClockFreq))

[Stack]

- Max Depth = 56
- Call Chain = HAL_RCC_GetSysClockFreq ⇒ __aeabi_uldivmod

[Calls]

- >> __aeabi_uldivmod

[Called By]

- >> HAL_RCC_ClockConfig

HAL_RCC_OscConfig (Thumb, 856 bytes, Stack size 40 bytes, stm32f4xx_hal_rcc.o(i.HAL_RCC_OscConfig))

[Stack]

- Max Depth = 40
- Call Chain = HAL_RCC_OscConfig

[Calls]

- >> HAL_GetTick

[Called By]

- >> SystemClock_Config

HAL_SYSTICK_Config (Thumb, 40 bytes, Stack size 8 bytes, stm32f4xx_hal_cortex.o(i.HAL_SYSTICK_Config))

[Stack]

- Max Depth = 8
- Call Chain = HAL_SYSTICK_Config

[Calls]

- >> __NVIC_SetPriority

[Called By]

- >> HAL_InitTick

HAL_UART_Init (Thumb, 98 bytes, Stack size 16 bytes, stm32f4xx_hal_uart.o(i.HAL_UART_Init))

[Stack]

- Max Depth = 88
- Call Chain = HAL_UART_Init ⇒ HAL_UART_MspInit ⇒ HAL_GPIO_Init

[Calls]

- >> UART_SetConfig
- >> HAL_UART_MspInit

[Called By]

- >> MX_USARTx_Init

HAL_UART_MspInit (Thumb, 78 bytes, Stack size 32 bytes, bsp_usartx.o(i.HAL_UART_MspInit))

[Stack]

- Max Depth = 72
- Call Chain = HAL_UART_MspInit ⇒ HAL_GPIO_Init

[Calls]

- >> HAL_GPIO_Init

[Called By]

- >> HAL_UART_Init

HAL_UART_Transmit (Thumb, 178 bytes, Stack size 32 bytes, stm32f4xx_hal_uart.o(i.HAL_UART_Transmit))

[Stack]

- Max Depth = 56
- Call Chain = HAL_UART_Transmit ⇒ UART_WaitOnFlagUntilTimeout

[Calls]

- >> UART_WaitOnFlagUntilTimeout
- >> HAL_GetTick

[Called By]

- >> main

HardFault_Handler (Thumb, 2 bytes, Stack size 0 bytes, stm32f4xx_it.o(i.HardFault_Handler))

[Calls]

- >> HardFault_Handler

[Called By]

- >> HardFault_Handler

[Address Reference Count : 1]

- startup_stm32f401xc.o(RESET)

MX_GPIO_Init (Thumb, 170 bytes, Stack size 40 bytes, gpio.o(i.MX_GPIO_Init))

[Stack]

- Max Depth = 80
- Call Chain = MX_GPIO_Init ⇒ HAL_GPIO_Init

[Calls]

- >> HAL_GPIO_WritePin
- >> HAL_GPIO_Init
- >> __aeabi_memclr4

[Called By]

- >> main

MX_USARTx_Init (Thumb, 72 bytes, Stack size 8 bytes, bsp_usartx.o(i.MX_USARTx_Init))

[Stack]

- Max Depth = 96
- Call Chain = MX_USARTx_Init ⇒ HAL_UART_Init ⇒ HAL_UART_MspInit ⇒ HAL_GPIO_Init

[Calls]

- >> HAL_UART_Init
- >> HAL_NVIC_SetPriority
- >> HAL_NVIC_EnableIRQ

[Called By]

- >> main

MemManage_Handler (Thumb, 2 bytes, Stack size 0 bytes, stm32f4xx_it.o(i.MemManage_Handler))

[Calls]

- >> MemManage_Handler

[Called By]

- >> MemManage_Handler

[Address Reference Count : 1]

- startup_stm32f401xc.o(RESET)

NMI_Handler (Thumb, 2 bytes, Stack size 0 bytes, stm32f4xx_it.o(i.NMI_Handler))

[Calls]

- >> NMI_Handler

[Called By]

- >> NMI_Handler

[Address Reference Count : 1]

- startup_stm32f401xc.o(RESET)

PendSV_Handler (Thumb, 2 bytes, Stack size 0 bytes, stm32f4xx_it.o(i.PendSV_Handler))
[Address Reference Count : 1]

- startup_stm32f401xc.o(RESET)

SVC_Handler (Thumb, 2 bytes, Stack size 0 bytes, stm32f4xx_it.o(i.SVC_Handler))
[Address Reference Count : 1]

- startup_stm32f401xc.o(RESET)

SysTick_Handler (Thumb, 4 bytes, Stack size 0 bytes, stm32f4xx_it.o(i.SysTick_Handler))

[Calls]

- >> HAL_IncTick

[Address Reference Count : 1]

- startup_stm32f401xc.o(RESET)

SystemClock_Config (Thumb, 138 bytes, Stack size 88 bytes, main.o(i.SystemClock_Config))

[Stack]

- Max Depth = 176
- Call Chain = SystemClock_Config ⇒ HAL_RCC_ClockConfig ⇒ HAL_RCC_GetSysClockFreq ⇒ __aeabi_uldivmod

[Calls]

- >> HAL_RCC_OscConfig
- >> HAL_RCC_ClockConfig
- >> __aeabi_memclr4

[Called By]

- >> main

SystemInit (Thumb, 12 bytes, Stack size 0 bytes, system_stm32f4xx.o(i.SystemInit))
[Address Reference Count : 1]

- startup_stm32f401xc.o(.text)

USART1_IRQHandler (Thumb, 86 bytes, Stack size 12 bytes, main.o(i.USART1_IRQHandler))

[Stack]

- Max Depth = 12
- Call Chain = USART1_IRQHandler

[Address Reference Count : 1]

- startup_stm32f401xc.o(RESET)

UsageFault_Handler (Thumb, 2 bytes, Stack size 0 bytes, stm32f4xx_it.o(i.UsageFault_Handler))

[Calls]

- >> UsageFault_Handler

[Called By]

- >> UsageFault_Handler

[Address Reference Count : 1]

- startup_stm32f401xc.o(RESET)

main (Thumb, 288 bytes, Stack size 80 bytes, main.o(i.main))

[Stack]

- Max Depth = 256
- Call Chain = main ⇒ SystemClock_Config ⇒ HAL_RCC_ClockConfig ⇒ HAL_RCC_GetSysClockFreq ⇒ __aeabi_uldivmod

[Calls]

- >> MX_USARTx_Init
- >> MX_GPIO_Init
- >> HAL_UART_Transmit
- >> HAL_Init
- >> HAL_Delay
- >> SystemClock_Config
- >> __aeabi_memcpy4
- >> strlen

[Called By]

- >> __rt_entry_main

_fp_init (Thumb, 10 bytes, Stack size 0 bytes, fpinit.o(x$fpl$fpinit))

[Called By]

- >> __rt_lib_init_fp_1

__fplib_config_fpu_vfp (Thumb, 0 bytes, Stack size unknown bytes, fpinit.o(x$fpl$fpinit), UNUSED)

__fplib_config_pureend_doubles (Thumb, 0 bytes, Stack size unknown bytes, fpinit.o(x$fpl$fpinit), UNUSED)

### Local Symbols

UART_SetConfig (Thumb, 258 bytes, Stack size 16 bytes, stm32f4xx_hal_uart.o(i.UART_SetConfig))

[Stack]

- Max Depth = 64
- Call Chain = UART_SetConfig ⇒ __aeabi_uldivmod

[Calls]

- >> HAL_RCC_GetPCLK2Freq
- >> HAL_RCC_GetPCLK1Freq
- >> __aeabi_uldivmod

[Called By]

- >> HAL_UART_Init

UART_WaitOnFlagUntilTimeout (Thumb, 120 bytes, Stack size 24 bytes, stm32f4xx_hal_uart.o(i.UART_WaitOnFlagUntilTimeout))

[Stack]

- Max Depth = 24
- Call Chain = UART_WaitOnFlagUntilTimeout

[Calls]

- >> HAL_GetTick

[Called By]

- >> HAL_UART_Transmit

__NVIC_SetPriority (Thumb, 32 bytes, Stack size 0 bytes, stm32f4xx_hal_cortex.o(i.__NVIC_SetPriority))

[Called By]

- >> HAL_NVIC_SetPriority
- >> HAL_SYSTICK_Config

### Undefined Global Symbols
