hafuli123/AcGun-Gun-File/手册/0.91OLED/03-原理图/0.91-IIC_SCH(14p).pdf

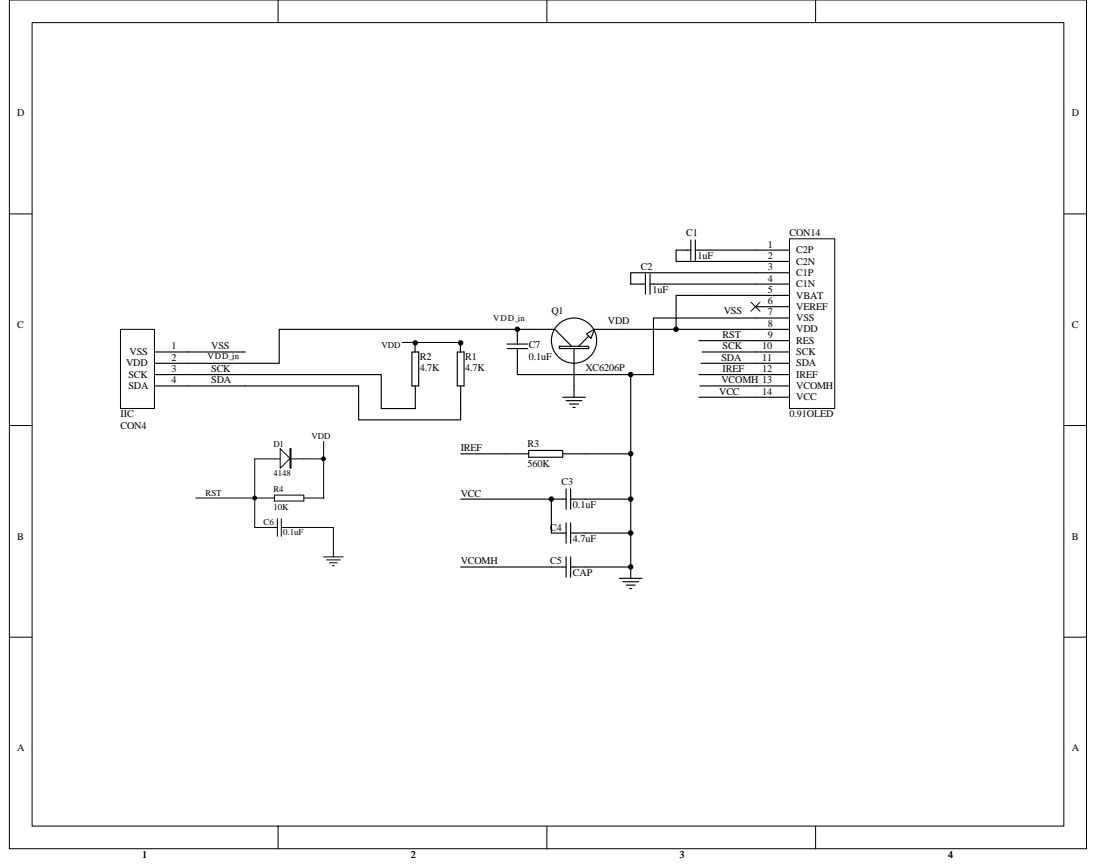
[picture p55: page 1]

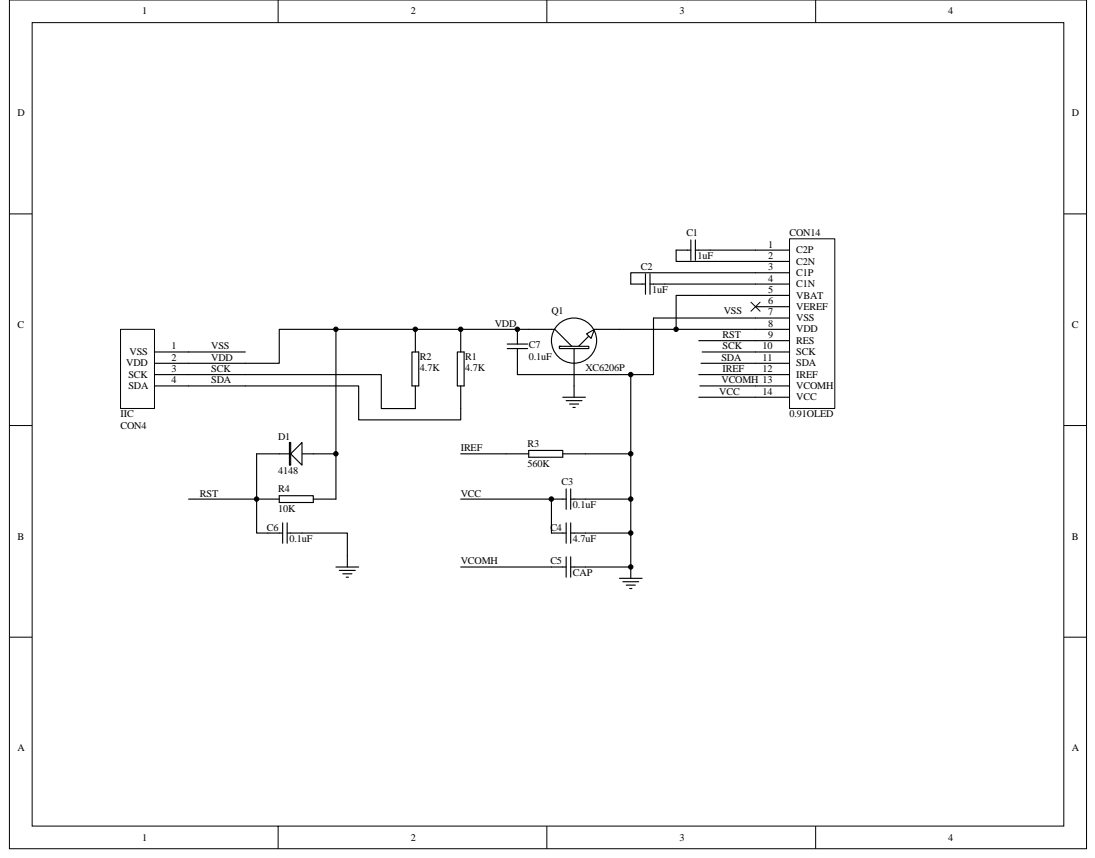
[picture p56: page 2]

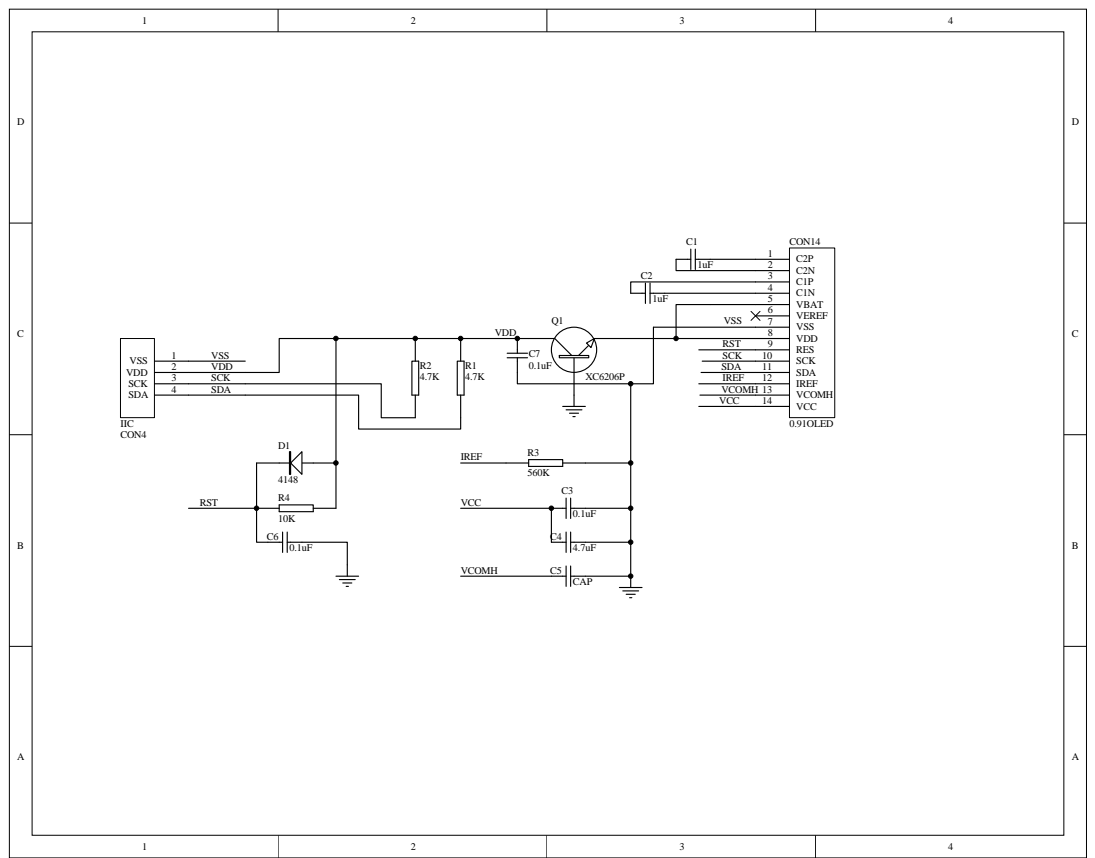
[picture p57: page 3]

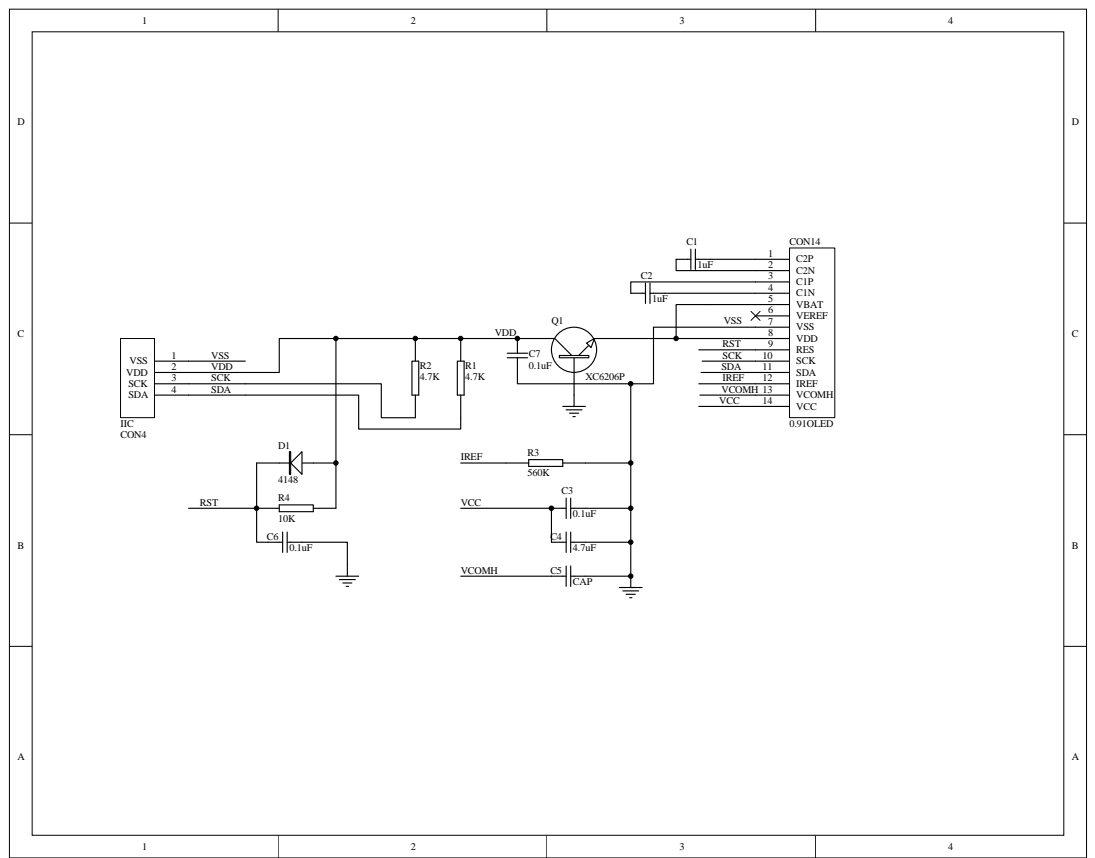
[picture p58: page 4]
