hafuli123/AcGun-Gun-File/(list of files, drawings)

Other design files:
传感器两小板/pcb/FSS1500-HANDv2.0.eprj
传感器两小板/pcb/磁感应板-2.0.eprj
手册/GC2400-TC010R资料包/PCB封装/封装图.PcbLib
硬件/AcGun2代.eprj
硬件/CameraTargetV3.eprj
