hafuli123/AcGun-Gun-File/软件/初始化无线模块/gc24init/Core/Src/main.c

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
/* Includes ------------------------------------------------------------------*/
#include "main.h"
//#include "usart.h"
#include "gpio.h"
#include "string.h"
#include "bsp_usartx.h"

/* USER CODE BEGIN PV */
#define RX_MAX_COUNT           30  // 串口接收最大字节数

/* 私有变量 ------------------------------------------------------------------*/
__IO uint8_t aRxBuffer[RX_MAX_COUNT]={0}; // 接收缓冲区
__IO uint16_t RxCount=0;                  // 已接收到的字节数
__IO uint8_t Frame_flag=0;                // 帧标志：1：一个新的数据帧  0：无数据帧

/* USER CODE END PV */

void SystemClock_Config(void);
/* USER CODE BEGIN 0 */
int apple,orange;
/* USER CODE END 0 */

/**
  * @brief  The application entry point.
  * @retval int
  */
	  uint8_t txbuf[50];
		uint32_t id,idr  ,ip=0x1234,ipr;uint8_t ids;
int main(void)
{
  /* MCU Configuration--------------------------------------------------------*/

  /* Reset of all peripherals, Initializes the Flash interface and the Systick. */
  HAL_Init();

  /* Configure the system clock */
  SystemClock_Config();

  /* Initialize all configured peripherals */
  MX_GPIO_Init();
	
	MX_USARTx_Init();
	__HAL_UART_ENABLE_IT(&husartx,UART_IT_RXNE);
	HAL_Delay(900);
	HAL_Delay(900);
	HAL_Delay(900);
	HAL_Delay(900);
	HAL_Delay(900);
/* 测试用 */
//	uint8_t txx1[]="AT+MODE=0\r\n";	
//	HAL_UART_Transmit(&husartx,txx1,strlen((char *)txx1),1000);
//	HAL_Delay(900);HAL_Delay(900);
//	uint8_t txx3[]="AT+PID=?\r\n";
//	HAL_UART_Transmit(&husartx,txx3,strlen((char *)txx3),1000);
//	HAL_Delay(900);HAL_Delay(900);
//		uint8_t txx8[]="AT+RFCH=?\r\n";
//	HAL_UART_Transmit(&husartx,txx8,strlen((char *)txx8),1000);
//	HAL_Delay(900);HAL_Delay(900);
//	uint8_t txx5[]="AT+MODE=1\r\n";
//	HAL_UART_Transmit(&husartx,txx5,strlen((char *)txx5),1000);
//	HAL_Delay(900);HAL_Delay(900);


/* 初始化用 */
	uint8_t txx1[]="AT+MODE=0\r\n";
	HAL_UART_Transmit(&husartx,txx1,strlen((char *)txx1),1000);
	HAL_Delay(900);HAL_Delay(900);
	
	uint8_t txx2[]="AT+RFBR=1000000\r\n";
	HAL_UART_Transmit(&husartx,txx2,strlen((char *)txx2),1000);
	HAL_Delay(900);HAL_Delay(900);
		
	uint8_t txx3[]="AT+PID=0\r\n";
	HAL_UART_Transmit(&husartx,txx3,strlen((char *)txx3),1000);
	HAL_Delay(900);HAL_Delay(900);
	
	uint8_t txx6[]="AT+RFCH=0\r\n";
	HAL_UART_Transmit(&husartx,txx6,strlen((char *)txx6),1000);
	HAL_Delay(900);HAL_Delay(900);
	
	uint8_t txx4[]="AT+UART=115200,0,0\r\n";
	HAL_UART_Transmit(&husartx,txx4,strlen((char *)txx4),1000);
	HAL_Delay(900);HAL_Delay(900);

	uint8_t txx5[]="AT+MODE=1\r\n";
	HAL_UART_Transmit(&husartx,txx5,strlen((char *)txx5),1000);
	HAL_Delay(900);HAL_Delay(900);

	apple=1;
  /* Infinite loop */
  /* USER CODE BEGIN WHILE */
	
	
  while (1)
  {
    /* USER CODE END WHILE */
    if(Frame_flag)  // 接收到一个完整数据帧
		{	
		  RxCount=0;    // 清除字节计数
   		Frame_flag=0; // 清除数据帧
		}
    /* USER CODE BEGIN 3 */
  }
  /* USER CODE END 3 */
}

void USARTx_IRQHANDLER(void)
{
	if(__HAL_USART_GET_FLAG(&husartx,USART_FLAG_RXNE)!= RESET)  // 接收中断：接收到数据
	{
//		apple++;
		uint8_t data;
		data=READ_REG(husartx.Instance->DR); // 读取数据
		if(RxCount==0) // 如果是重新接收到数据帧，开启串口空闲中断
		{
			__HAL_UART_CLEAR_FLAG(&husartx,USART_FLAG_IDLE); // 清除空闲中断标志
		  __HAL_UART_ENABLE_IT(&husartx,UART_IT_IDLE);     // 使能空闲中断	    
		}
		if(RxCount<RX_MAX_COUNT)    // 判断接收缓冲区未满
		{
			aRxBuffer[RxCount]=data;  // 保存数据
			RxCount++;                // 增加接收字节数计数
		}
	}
	else	if(__HAL_USART_GET_FLAG(&husartx,USART_FLAG_IDLE)!= RESET) // 串口空闲中断
	{
		__HAL_UART_CLEAR_FLAG(&husartx,USART_FLAG_IDLE); // 清除空闲中断标志
		__HAL_UART_DISABLE_IT(&husartx,UART_IT_IDLE);    // 关闭空闲中断
		Frame_flag=1;		                                 // 数据帧置位，标识接收到一个完整数据帧
	}
}

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
/* USER CODE BEGIN 4 */
//void HAL_UART_RxCpltCallback(UART_HandleTypeDef *UartHandle)
//{
////  HAL_UART_Transmit(&husartx,&aRxBuffer,1,0);
//  HAL_UART_Receive_IT(&husartx,&aRxBuffer,3);
//}
/* USER CODE END 4 */
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
