hafuli123/AcGun-Gun-File/软件/软件测试压力值/getpvol/Core/Inc/gpio.h

/**
  ******************************************************************************
  * @file    gpio.h
  * @brief   This file contains all the function prototypes for
  *          the gpio.c file
  ******************************************************************************
  * @attention
  *
  * <h2><center>&copy; Copyright (c) 2022 STMicroelectronics.
  * All rights reserved.</center></h2>
  *
  * This software component is licensed by ST under BSD 3-Clause license,
  * the "License"; You may not use this file except in compliance with the
  * License. You may obtain a copy of the License at:
  *                        opensource.org/licenses/BSD-3-Clause
  *
  ******************************************************************************
  */
/* Define to prevent recursive inclusion -------------------------------------*/
#ifndef __GPIO_H__
#define __GPIO_H__

#ifdef __cplusplus
extern "C" {
#endif

/* Includes ------------------------------------------------------------------*/
#include "main.h"

void MX_GPIO_Init(void);

/* USER CODE BEGIN Prototypes */
#define MRS_GPIO GPIOB
#define MRS_PIN GPIO_PIN_4
#define MRS_RELEASE GPIO_PIN_SET
#define MRS_ON      GPIO_PIN_RESET
/* USER CODE END Prototypes */

#ifdef __cplusplus
}
#endif
#endif /*__ GPIO_H__ */

/************************ (C) COPYRIGHT STMicroelectronics *****END OF FILE****/
