hafuli123/AcGun-Gun-File/(notices)

Notices in the files:
软件/初始化无线模块/gc24init/Core/Src/main.c:
© Copyright (c) 2023 STMicroelectronics.
All rights reserved.
软件/初始化无线模块/gc24init/Core/Inc/bsp_usartx.h:
(C) COPYRIGHT 2015-2020 Ó²Ê¯Ç¶ÈëÊ½¿ª·¢ÍÅ¶Ó *****END OF FILE
